CDRXavier/XpandShield/README.txt

XpandShield
Expansion Shield with multiple I/O. General Purpose.

XpandShield_MK1 uses buttons and are natively Arduboy compatiable.
XpandShield_MK2 uses potentialmeters and might not be natively Arduboy compatiable. However, the display wiring is the same.

For detailed info, click on the individual folders.
