CDRXavier/XpandShield/XpandShield_MK1/PCBoard/XpandShield_MK1.sch

## KiCad design XpandShield_MK1/XpandShield_MK1.sch (2021-06-25, an earlier design)

Schematic: XpandShield_MK1.sch

Parts:
BZ0: Buzzer
D0: SR240
D4: LED
J1: Display
J2: ExpandConnector
R1: R_US
SW0: SW_DPDT
U1: MAX1811; SOIC-8_3.9x4.9mm_P1.27mm
