CDRXavier/XpandShield/XpandShield_MK2/MK2_1/MK2_1.sch

## KiCad design XpandShield_MK2/MK2_1/MK2_1.sch (2021-08-03)

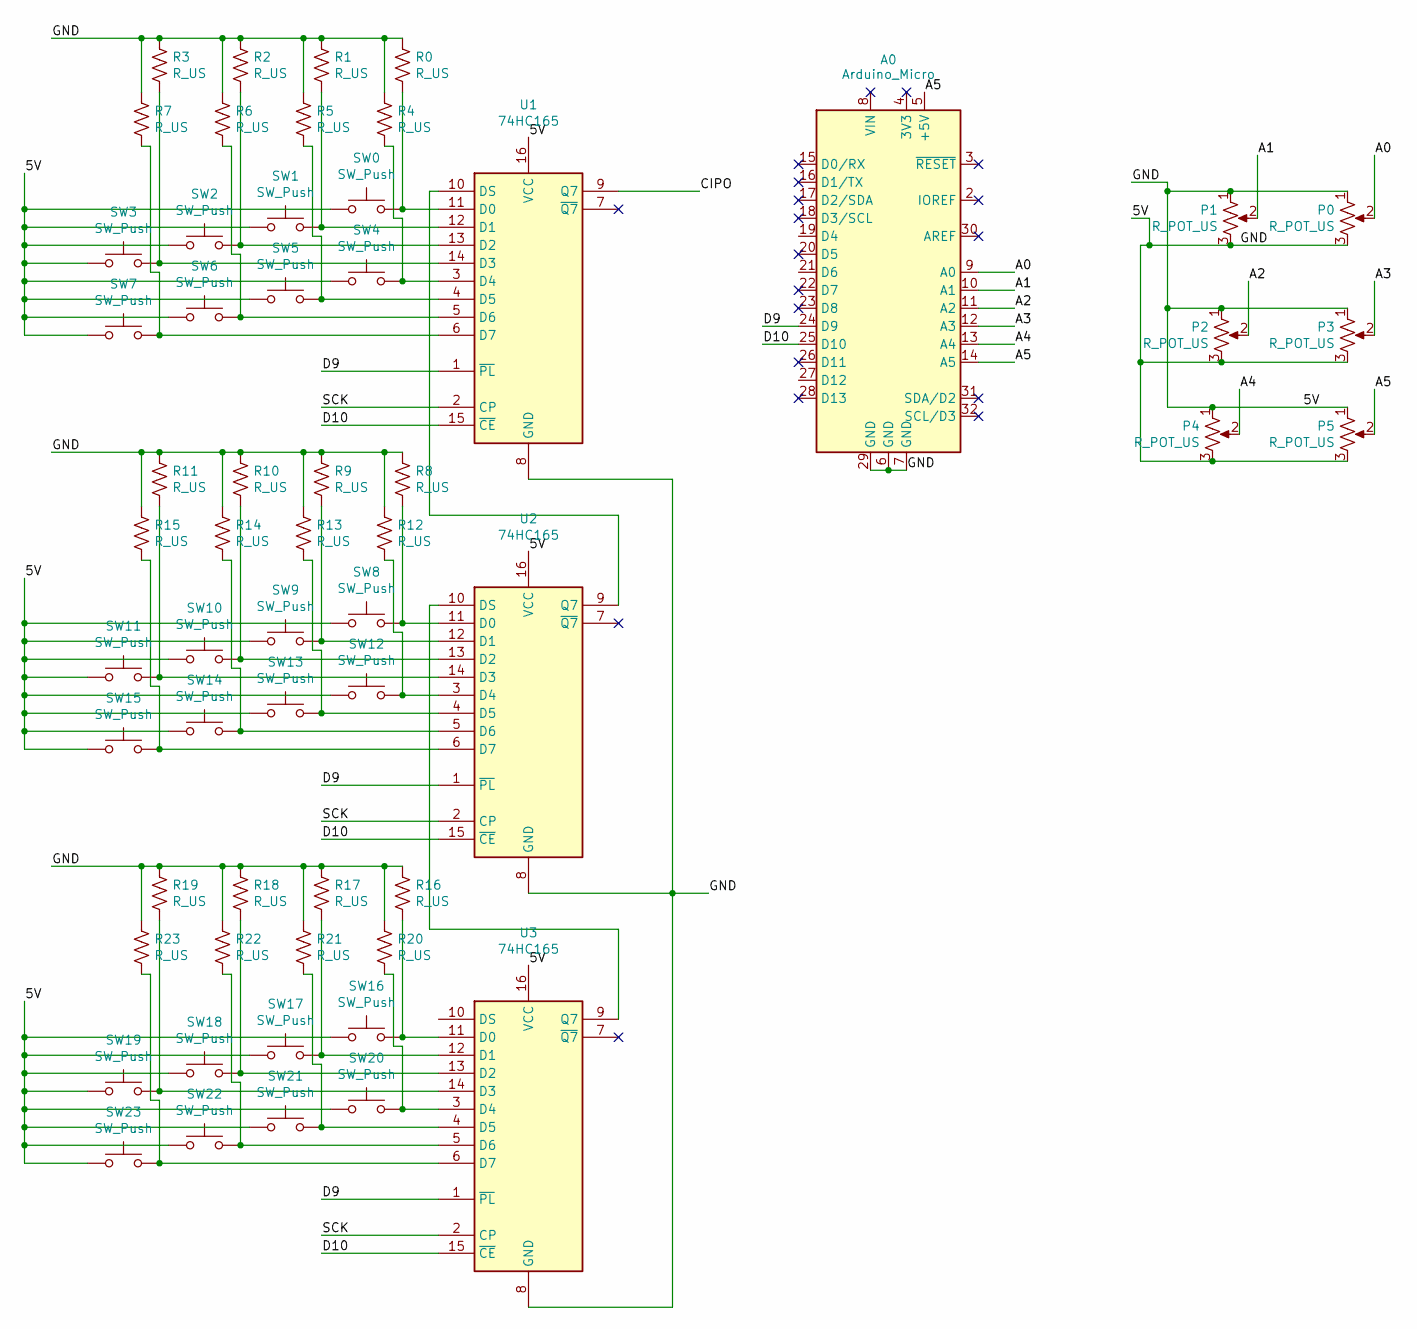
[picture p1: schematic MK2_1.sch]

Parts:
A0: Arduino_Micro
P0, P1, P2, P3, P4, P5: R_POT_US
R0, R1, R2, R3, R4, R5, R6, R7, R8, R9, R10, R11, R12, R13, R14, R15, R16, R17, R18, R19, R20, R21, R22, R23: R_US
SW0, SW1, SW2, SW3, SW4, SW5, SW6, SW7, SW8, SW9, SW10, SW11, SW12, SW13, SW14, SW15, SW16, SW17, SW18, SW19, SW20, SW21, SW22, SW23: SW_Push
U1, U2, U3: 74HC165

Connections:
5V: A0.6 (GND), A0.7 (GND), A0.29 (GND), P0.1, P0.3, P1.1, P1.3, P2.1, P2.3, P3.1, P3.3, P4.1, P4.3, P5.1, P5.3, R0.1, R1.1, R2.1, R3.1, R4.1, R5.1, R6.1, R7.1, R8.1, R9.1, R10.1, R11.1, R12.1, R13.1, R14.1, R15.1, R16.1, R17.1, R18.1, R19.1, R20.1, R21.1, R22.1, R23.1, SW0.1, SW1.1, SW2.1, SW3.1, SW4.1, SW5.1, SW6.1, SW7.1, SW8.1, SW9.1, SW10.1, SW11.1, SW12.1, SW13.1, SW14.1, SW15.1, SW16.1, SW17.1, SW18.1, SW19.1, SW20.1, SW21.1, SW22.1, SW23.1, U1.8 (GND), U1.16 (VCC), U2.8 (GND), U2.16 (VCC), U3.8 (GND), U3.16 (VCC)
A0: A0.9 (A0), P0.2
A1: A0.10 (A1), P1.2
A2: A0.11 (A2), P2.2
A3: A0.12 (A3), P3.2
A4: A0.13 (A4), P4.2
A5: A0.5 (+5V), A0.14 (A5), P5.2
CIPO: U1.9 (Q7)
D9: A0.24 (D9), U1.1 (~PL), U2.1 (~PL), U3.1 (~PL)
D10: A0.25 (D10), U1.15 (~CE), U2.15 (~CE), U3.15 (~CE)
unnamed: R0.2, SW0.2, U1.11 (D0)
unnamed: R1.2, SW1.2, U1.12 (D1)
unnamed: R2.2, SW2.2, U1.13 (D2)
unnamed: R3.2, SW3.2, U1.14 (D3)
unnamed: R4.2, SW4.2, U1.3 (D4)
unnamed: R5.2, SW5.2, U1.4 (D5)
unnamed: R6.2, SW6.2, U1.5 (D6)
unnamed: R7.2, SW7.2, U1.6 (D7)
unnamed: R8.2, SW8.2, U2.11 (D0)
unnamed: R9.2, SW9.2, U2.12 (D1)
unnamed: R10.2, SW10.2, U2.13 (D2)
unnamed: R11.2, SW11.2, U2.14 (D3)
unnamed: R12.2, SW12.2, U2.3 (D4)
unnamed: R13.2, SW13.2, U2.4 (D5)
unnamed: R14.2, SW14.2, U2.5 (D6)
unnamed: R15.2, SW15.2, U2.6 (D7)
unnamed: R16.2, SW16.2, U3.11 (D0)
unnamed: R17.2, SW17.2, U3.12 (D1)
unnamed: R18.2, SW18.2, U3.13 (D2)
unnamed: R19.2, SW19.2, U3.14 (D3)
unnamed: R20.2, SW20.2, U3.3 (D4)
unnamed: R21.2, SW21.2, U3.4 (D5)
unnamed: R22.2, SW22.2, U3.5 (D6)
unnamed: R23.2, SW23.2, U3.6 (D7)
unnamed: U1.10 (DS), U2.9 (Q7)
unnamed: U2.10 (DS), U3.9 (Q7)
SCK: U1.2 (CP), U2.2 (CP), U3.2 (CP)
