CDRXavier/XpandShield/(commit log)

2021-06-25 Changed Files Directory
    [MK1_2.kicad_pcb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]
2021-06-25 Updated MK_1 PCB files
    [XpandShield_MK1.sch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]
2021-07-03 Updated MK1 PCBs
    [MK1_1.kicad_pcb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]
2021-08-03 Added MK2_1 PCB files
    [MK2_1-B_Cu.gbr, MK2_1-B_Mask.gbr, MK2_1-Cmts_User.gbr, MK2_1-Edge_Cuts.gbr, MK2_1-F_Cu.gbr, MK2_1-F_Mask.gbr, MK2_1-NPTH.drl, MK2_1-PTH.drl]
2021-08-03 Deleted old Fabrication Files
    [MK2_1-B_Cu.gbr, MK2_1-B_Mask.gbr, MK2_1-Cmts_User.gbr, MK2_1-Edge_Cuts.gbr, MK2_1-F_Cu.gbr, MK2_1-F_Mask.gbr, MK2_1-NPTH.drl, MK2_1-PTH.drl]
2021-08-03 Updated PCB
    [MK2_1.kicad_pcb, MK2_1.sch]
2021-08-11 Updated Board
    [MK2_1-B_Cu.gbr, MK2_1-B_Mask.gbr, MK2_1-Edge_Cuts.gbr, MK2_1-F_Cu.gbr, MK2_1-F_Mask.gbr, MK2_1-NPTH.drl, MK2_1-PTH.drl, MK2_1-job.gbrjob]
2021-08-11 Added MK1_0 for historical reasons
    [MK1_0.kicad_pcb]
2021-08-11 Updated MK1_3 board
    [MK1_3.kicad_pcb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]
2021-08-15 Update MK2 Files
    [MK2_1.kicad_pcb]
2022-01-22 Update MK1_2 Files
    [MK1_1_2.kicad_pcb]
2022-03-19 Updated MK1_3 Design
    [MK1_3.kicad_pcb]
2024-03-15 added duplicate arduino library files for modification
2024-04-25 Changed PCB
    [MK2_1.kicad_pcb]
