CDRXavier/XpandShield/(notices)

Notices in the files:
XpandShield_MK2/Sketches/XpandMouseU/XpandMouseU.ino:
modify it under the terms of the GNU Public License as published by
the Free Software Foundation; either version 2.1 of the License,
or (at your option) any later version.
